TRANPHUONGNAM2912/Automated_door_systems_with_surveillance_camera_integration/docs/README.md

# Tài liệu Hệ thống Cửa Tự động Kết hợp Camera Giám sát

Thư mục này chứa tài liệu và hướng dẫn cho dự án hệ thống cửa tự động.

## Cấu trúc thư mục

- `images/`: Hình ảnh và sơ đồ minh họa
- `user_manual/`: Hướng dẫn sử dụng cho người dùng
- `AutoDoor_App.pdf`: Tài liệu kỹ thuật và sơ đồ mạch

## Hướng dẫn sử dụng

Hướng dẫn sử dụng đầy đủ có trong tệp `user_manual/huong_dan_su_dung.md`. Tài liệu này cung cấp:

- Giới thiệu hệ thống
- Hướng dẫn cài đặt
- Cách sử dụng các tính năng
- Xử lý sự cố thường gặp
- Bảo trì hệ thống

## Sơ đồ kỹ thuật

Tài liệu `AutoDoor_App.pdf` bao gồm:

- Sơ đồ mạch điện chi tiết
- Danh sách linh kiện
- Hướng dẫn lắp ráp
- Thông số kỹ thuật

## Đóng góp và phát triển

Nếu bạn muốn đóng góp vào dự án, vui lòng đọc tài liệu hướng dẫn trước để hiểu về kiến trúc và hoạt động của hệ thống.

## Tác giả

Trần Phương Nam - tranphuongnam292003@gmail.com
