TRANPHUONGNAM2912/Automated_door_systems_with_surveillance_camera_integration/(list of files, drawings)

Other design files:
hardware/schematic/AutoDoor_App.SchDoc
