TRANPHUONGNAM2912/Automated_door_systems_with_surveillance_camera_integration/firmware/esp32_main/esp_esp32cam/config.cpp

/*
 * Hệ thống Cửa Tự động Kết hợp Camera Giám sát
 * 
 * File cấu hình hệ thống - Định nghĩa biến
 * 
 * Tác giả: Trần Phương Nam
 * Email: tranphuongnam292003@gmail.com
 */

#include "config.h"

// WiFi configuration
const char* WIFI_SSID = "wifi";
const char* WIFI_PASSWORD = "11111111";

// Default password
char DEFAULT_PASSWORD[5] = "1234"; 
