TRANPHUONGNAM2912/Automated_door_systems_with_surveillance_camera_integration/(notices)

Notices in the files:
README.md:
License: MIT
